eduardburlacu/IDP/README.md

# IDP

## Dimensions
- Truck Height: 95mm
- Tunnel Width: 345mm
- Tunnel Length: 510mm
-
