eduardburlacu/IDP/Non-Technical/Project Management/Introductory Presentation IDP.pptx

## Introductory Presentation

Team Name: Work In Progress

## Management Structure

Mechanical | Electrical | Software
Aadam Iftikhar | Thomas Gaertner | Daniel Rivlin
Gabriel Bednarkiewicz | Andrew Farquharson | Eduard Burlacu

*It is important to note that these are loose descriptions, with members reassigned to various roles as the project requires.

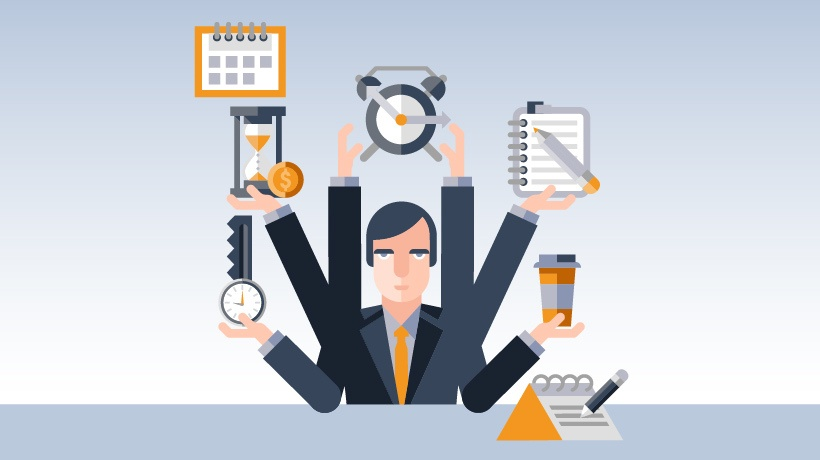
[picture p1: figure]

## Team Organisation

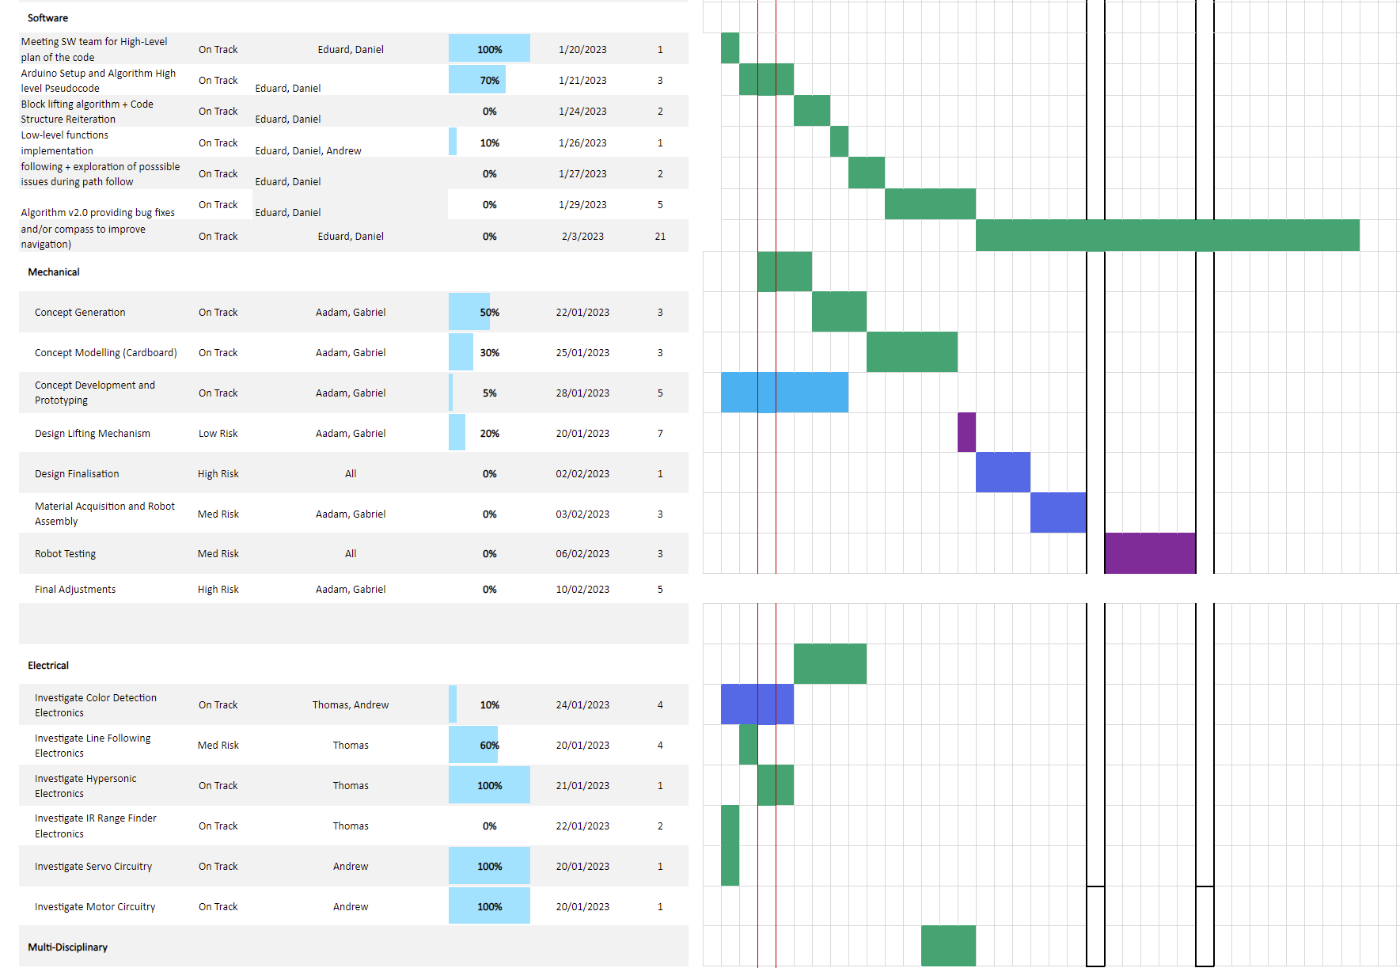
[picture p2: figure]

- Created a Gantt Chart including deadlines, work distribution, and projected timeline
- Documents and file organisation using cloud storage, version control (GitHub)
- Issues and communication addressed on a common groupchat and Issues section of repository

## THE PROBLEM

- Navigate from start point to end point and back
  - Drivetrain and navigation system required
  - Passing through tunnel and over ramp, adds additional constraints
- Collect a block from designated point
- Lift block 100mm onto truck

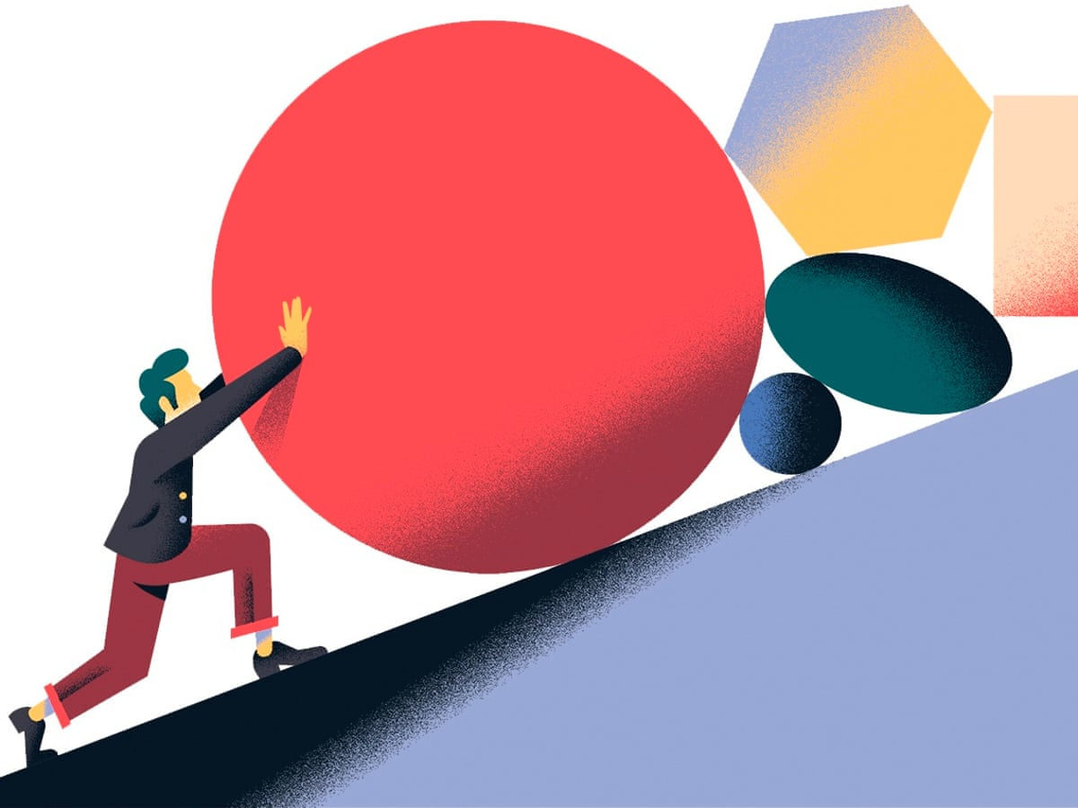
[picture p3: figure]

## SOLUTION CONCEPTS

- Navigation: Line-following (possible compass or computer vision as redundancies)
- Drivetrain: Two rear wheels, ball bearing at the front, allows for turning on the spot
- Block Collection: claw powered by servo motor
- Block Elevation: Use claw attached to lever arm mechanism

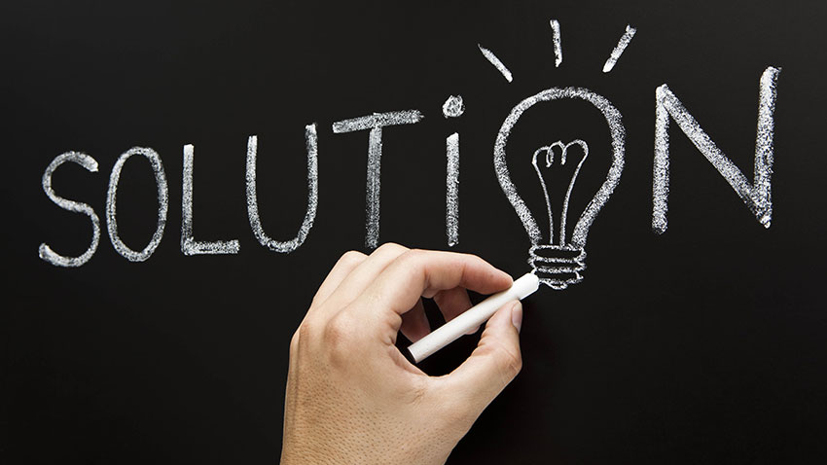
[picture p4: figure]

## Approaches

- Provided prototypes for:
  - Claw movement
  - Lift mechanism
  - Electronics and software logic

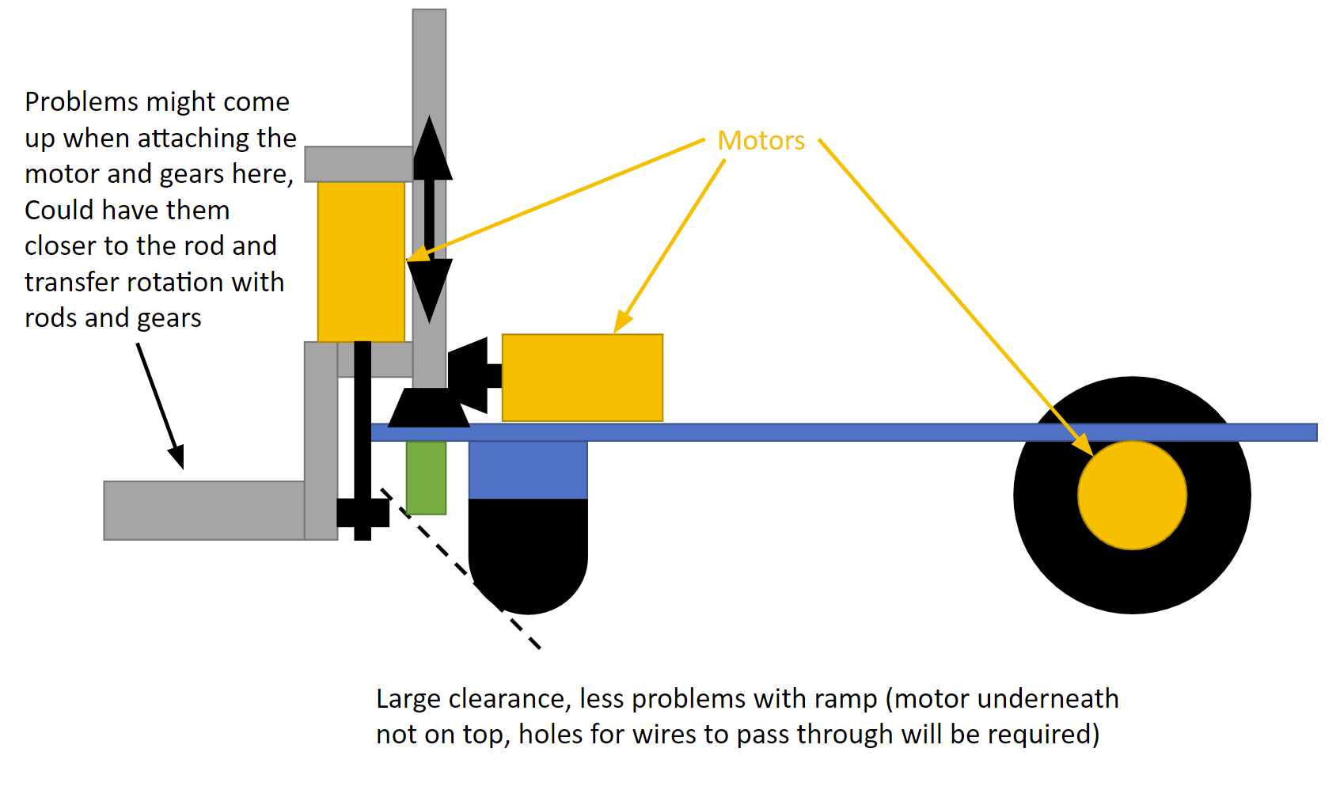
[picture p5: figure]
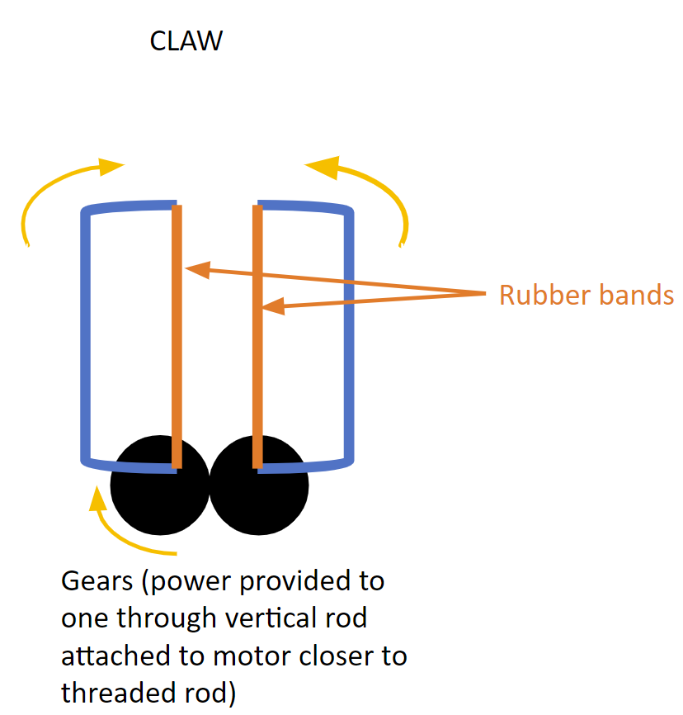
[picture p6: figure]
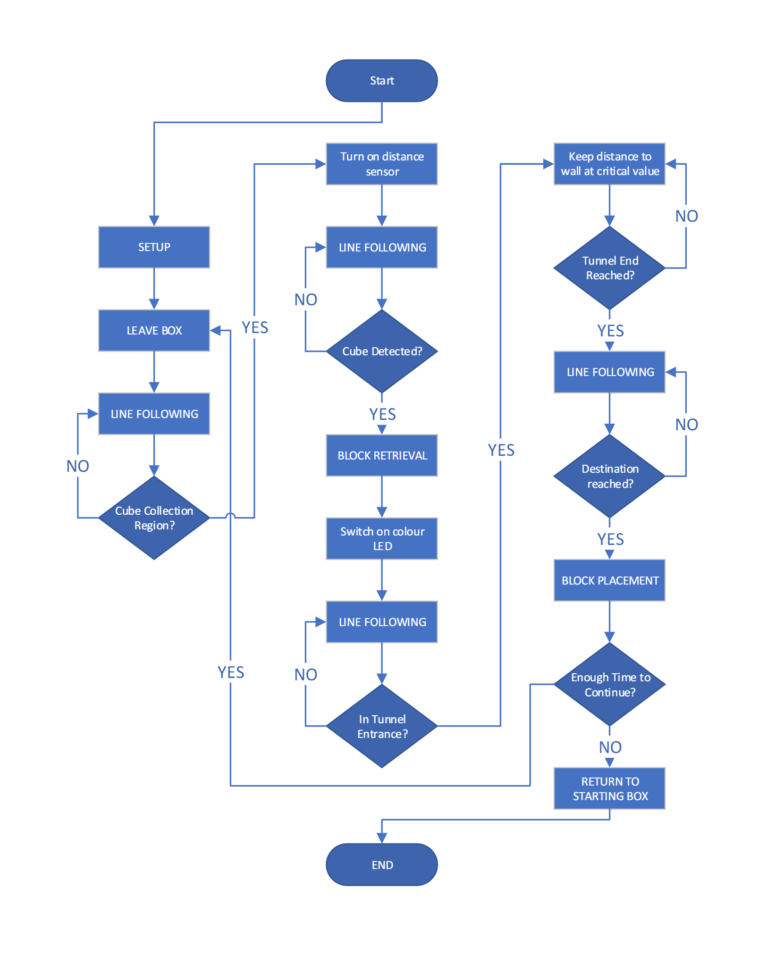
[picture p7: figure]

## Limitations

- Tunnel does not have line, accurate orientation and travel distance measurement required, limit switches as possible redundancies
- Enough torque to climb ramp is required
- Stalling servo motor is a risk, use of rubber bands to increase friction and prevent stalling
- For lifting mechanism: height of tunnel and complexity of design may increase fabrication time, claw with attached motor is heavy
- Minimum clearance to ascend ramp required
- Tunnel width limits size.

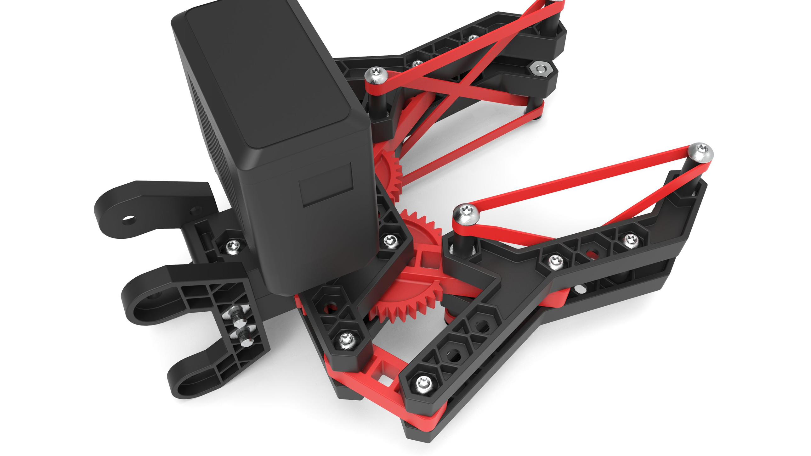
[picture p8: figure]
Robotic Claw - V5 VEX Robotics - Mecânica |Autodesk Online Gallery

## ANY QUESTIONS?

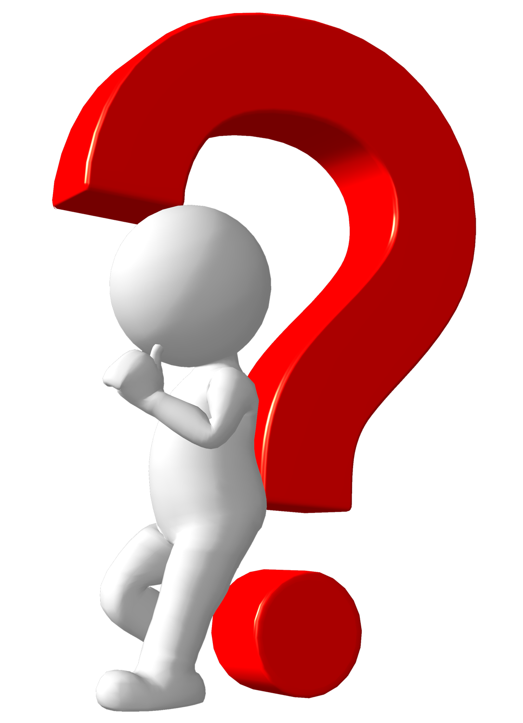
[picture p9: figure]
What is a good question? | Dragonfly Training
