eduardburlacu/IDP/Software/Charts & Diagrams/flowchart_2.pdf

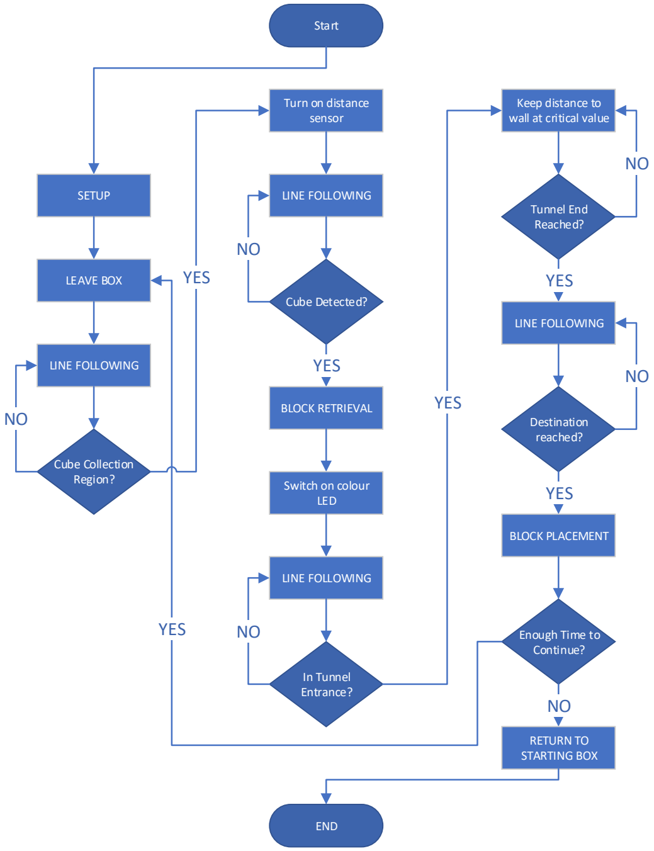
[picture p10: figure]
Start; SETUP; LEAVE BOX; LINE FOLLOWING; Cube Collection Region?; Cube Detected?; YES; BLOCK RETRIEVAL; Turn on distance sensor; Switch on colour LED; In Tunnel Entrance?; Keep distance to wall at critical value; Tunnel End Reached?; Destination reached?; BLOCK PLACEMENT; Enough Time to Continue?; RETURN TO STARTING BOX; END
