eduardburlacu/IDP/Software/Charts & Diagrams/flowchart_1.pdf

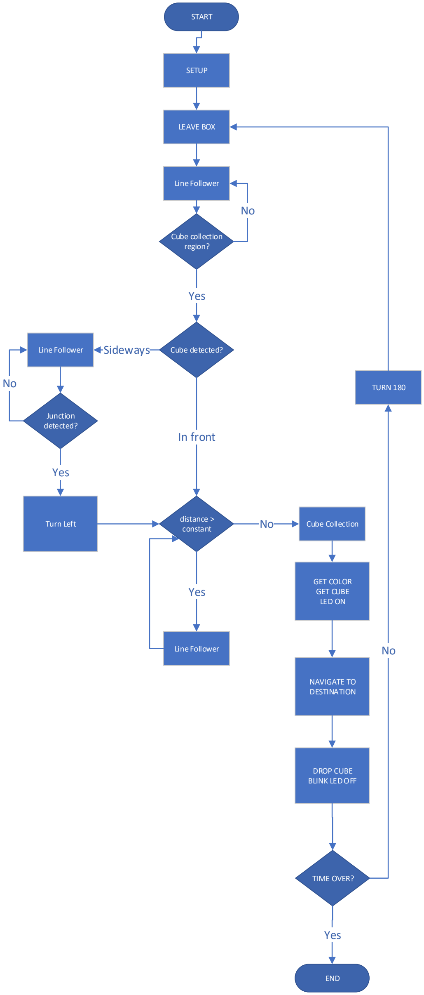
[picture p11: figure]
START; SETUP; GET COLOR GET CUBE LED ON; DROP CUBE BLINK LED OFF; TIME OVER?; END; LEAVE BOX; Line Follower; TURN 180; Cube Collection; Cube collection region?; Yes; Cube detected?; In front; distance > constant; Sideways; Junction detected?; Turn Left; NAVIGATE TO DESTINATION
