eduardburlacu/IDP/Electrical/Circuits/Line follower.png

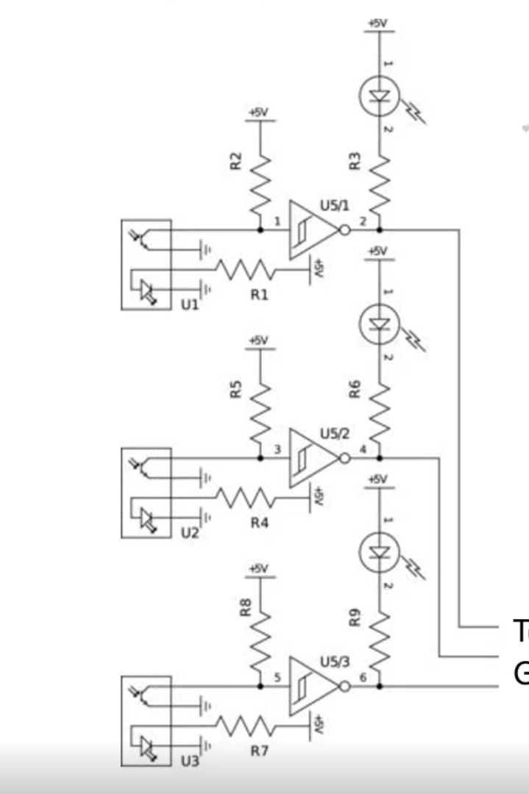
Electrical/Circuits/Line follower.png
