eduardburlacu/IDP/Mechanical/Claw/Claw.SLDASM

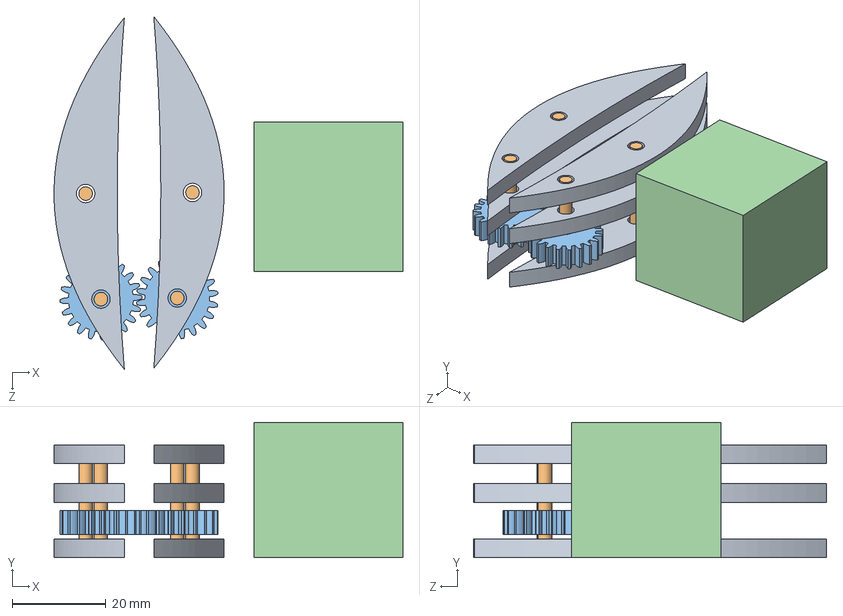
[picture p13: CAD file, 2023-01-27]
Mechanical/Claw/Claw.SLDASM
74.4 x 28.8 x 75.2 mm
Claw pincer left x 6
Rod x 4
spur gear_ai x 2
Block
