eduardburlacu/IDP/Mechanical/Claw/Block.SLDPRT

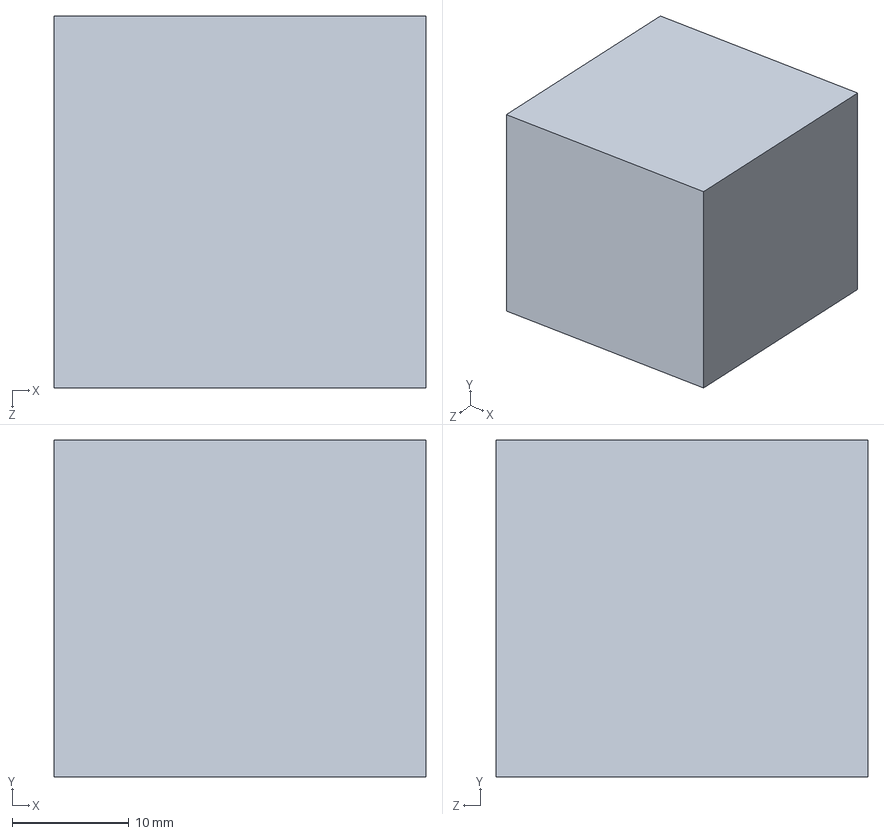
[picture p14: CAD file, 2023-01-27]
Mechanical/Claw/Block.SLDPRT
31.8 x 28.8 x 31.8 mm
