eduardburlacu/IDP/Mechanical/Claw/Rod.SLDPRT

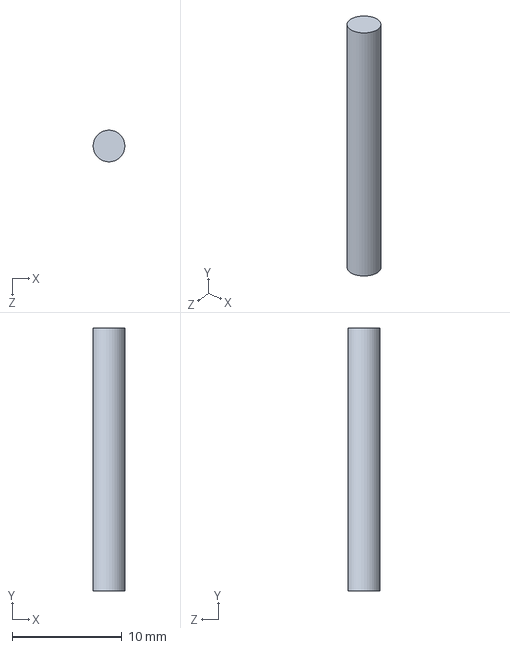
[picture p15: CAD file, 2023-01-27]
Mechanical/Claw/Rod.SLDPRT
2.90 x 24.0 x 2.90 mm
