eduardburlacu/IDP/Mechanical/Claw/Claw pincer left.SLDPRT

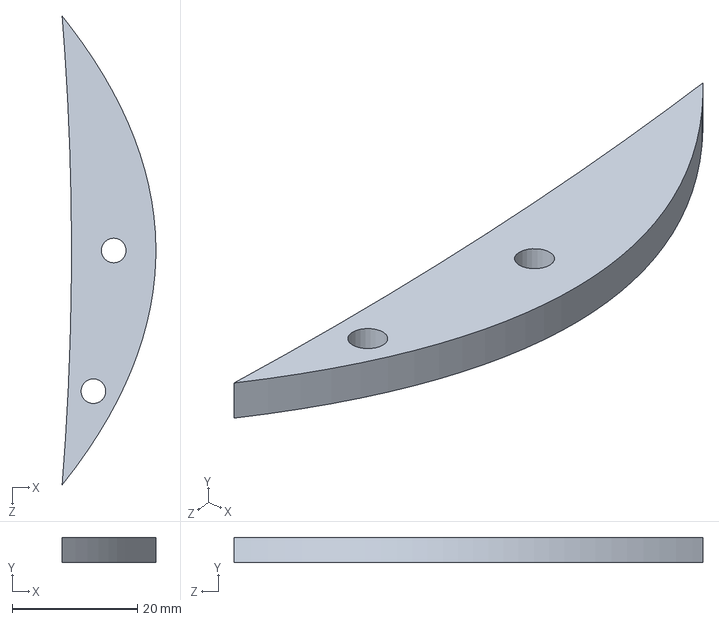
[picture p16: CAD file, 2023-01-27]
Mechanical/Claw/Claw pincer left.SLDPRT
15.0 x 4.00 x 75.0 mm
