eduardburlacu/IDP/Software/Charts & Diagrams/state_chart.pdf

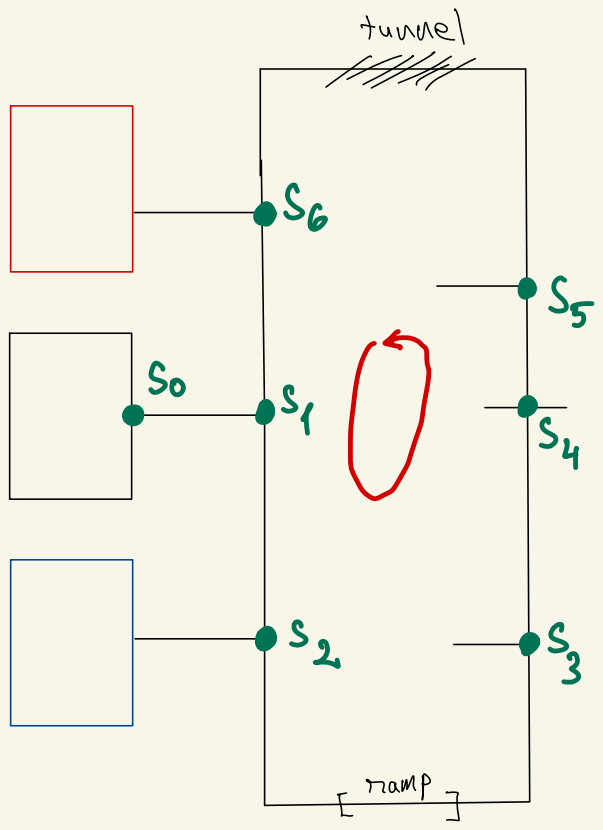
[picture p17: page 1]
namp]
