eduardburlacu/IDP/Electrical/Circuits/Timer LTSpice Schematic.asc

C1: cap; 0.01µ
C2: cap; 22µ
D1: LED; LXHL-BW02
R1: res; 20k
R2: res; 6.7k
R3: res; 100
R4: res; 1k
U1: NE555
V1: voltage; 5V
Named nets: 0, +5V, out, RST, Trig, Disch, thrs
.tran 10s
Timer can sink/source 200 mA on the output pin so no need to buffer
