eduardburlacu/IDP/Electrical/IDP/Work In Progress.brd

## EAGLE design Electrical/IDP/Work In Progress.brd (2023-01-31)

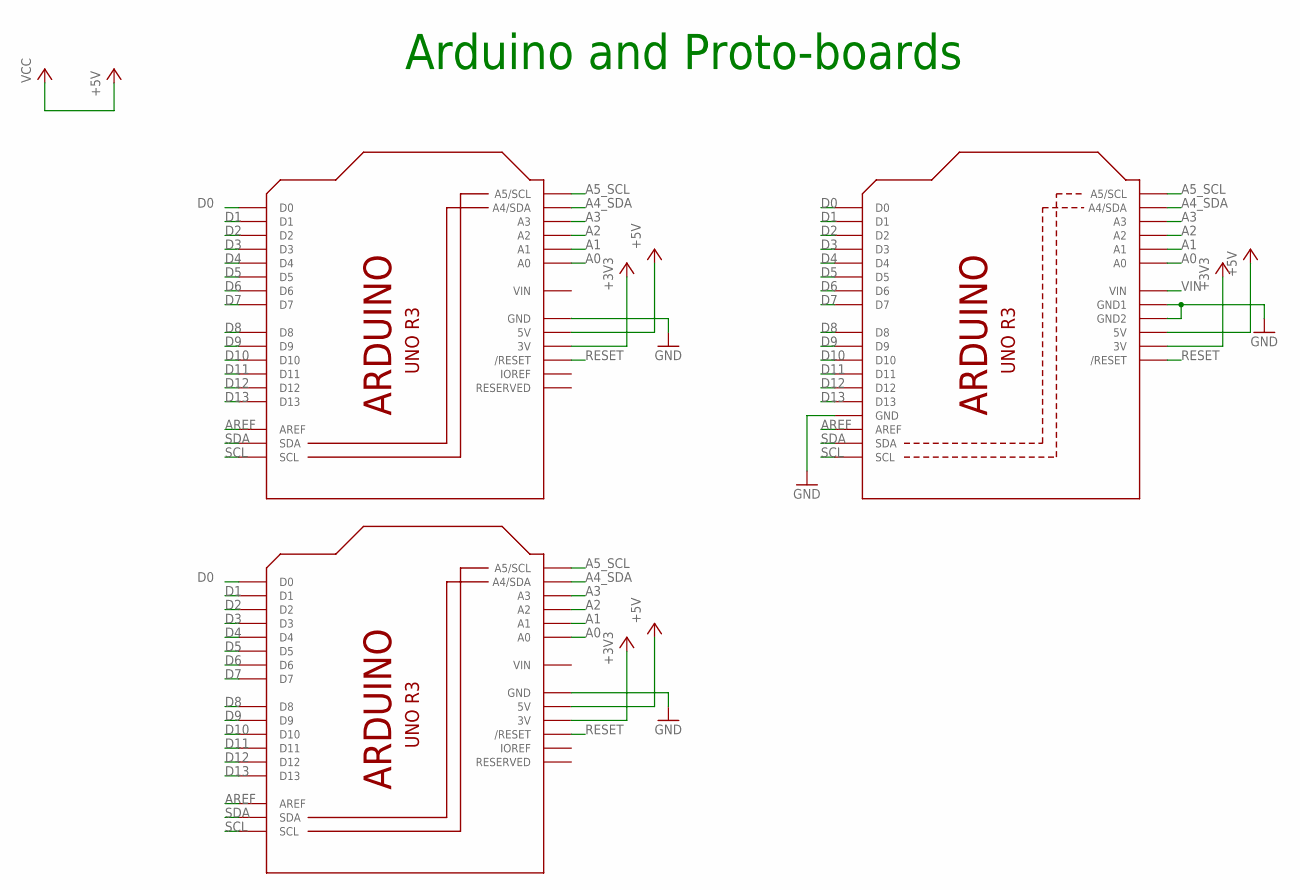
[picture p18: schematic Work In Progress.sch, sheet 1, Arduino and Proto-boards]

Parts:
M1, M2: IDP_PROTOBOARD_LARGE_LARGE; IDP_PROTO_LARGE
Q1: ARDUINOR3-NOIOREF-NOTEXT; ARDUINOR3-NOTEXT-NOIOREF

Connections:
+3V3: M1.3V, M2.3V, Q1.3V
+5V: M1.5V, M1.5V@0 (5V), M1.5V@1 (5V), M1.5V@2 (5V), M1.5V@3 (5V), M1.5V@4 (5V), M1.5V@5 (5V), M1.5V@6 (5V), M1.5V@7 (5V), M1.5V@8 (5V), M1.5V@9 (5V), M1.5V@10 (5V), M1.5V@11 (5V), M1.5V@12 (5V), M1.5V@13 (5V), M1.5V@14 (5V), M1.5V@15 (5V), M1.5V@16 (5V), M1.5V@17 (5V), M1.5V@18 (5V), M1.5V@19 (5V), M1.5V@20 (5V), M1.5V@21 (5V), M1.5V@22 (5V), M1.5V@23 (5V), M1.5V@24 (5V), M1.5V@25 (5V), M1.5V@26 (5V), M1.5V@27 (5V), M1.5V@28 (5V), M1.5V@29 (5V), M1.5V@30 (5V), M1.5V@31 (5V), M1.5V@32 (5V), M1.5V@33 (5V), M1.5V@34 (5V), M1.5V@35 (5V), M1.5V@36 (5V), M1.5V@37 (5V), M1.5V@38 (5V), M1.5V@39 (5V), M1.5V@40 (5V), M1.5V@41 (5V), M1.5V@42 (5V), M1.5V@43 (5V), M1.5V@44 (5V), M1.5V@45 (5V), M1.5V@46 (5V), M1.5V@47 (5V), M1.5V@48 (5V), M1.5V@49 (5V), M1.5V@50 (5V), M1.5V@51 (5V), M1.5V@52 (5V), M1.5V@53 (5V), M1.5V@54 (5V), M1.5V@55 (5V), M1.5V@56 (5V), M1.5V@57 (5V), M1.5V@58 (5V), M1.5V@59 (5V), M1.5V@60 (5V), M1.5V@61 (5V), M1.5V@62 (5V), M1.5V@63 (5V), M1.5V@64 (5V), M1.5V@65 (5V), M1.5V@66 (5V), M1.5V@67 (5V), M1.5V@68 (5V), M1.5V@69 (5V), M1.5V@70 (5V), M2.5V, M2.5V@0 (5V), M2.5V@1 (5V), M2.5V@2 (5V), M2.5V@3 (5V), M2.5V@4 (5V), M2.5V@5 (5V), M2.5V@6 (5V), M2.5V@7 (5V), M2.5V@8 (5V), M2.5V@9 (5V), M2.5V@10 (5V), M2.5V@11 (5V), M2.5V@12 (5V), M2.5V@13 (5V), M2.5V@14 (5V), M2.5V@15 (5V), M2.5V@16 (5V), M2.5V@17 (5V), M2.5V@18 (5V), M2.5V@19 (5V), M2.5V@20 (5V), M2.5V@21 (5V), M2.5V@22 (5V), M2.5V@23 (5V), M2.5V@24 (5V), M2.5V@25 (5V), M2.5V@26 (5V), M2.5V@27 (5V), M2.5V@28 (5V), M2.5V@29 (5V), M2.5V@30 (5V), M2.5V@31 (5V), M2.5V@32 (5V), M2.5V@33 (5V), M2.5V@34 (5V), M2.5V@35 (5V), M2.5V@36 (5V), M2.5V@37 (5V), M2.5V@38 (5V), M2.5V@39 (5V), M2.5V@40 (5V), M2.5V@41 (5V), M2.5V@42 (5V), M2.5V@43 (5V), M2.5V@44 (5V), M2.5V@45 (5V), M2.5V@46 (5V), M2.5V@47 (5V), M2.5V@48 (5V), M2.5V@49 (5V), M2.5V@50 (5V), M2.5V@51 (5V), M2.5V@52 (5V), M2.5V@53 (5V), M2.5V@54 (5V), M2.5V@55 (5V), M2.5V@56 (5V), M2.5V@57 (5V), M2.5V@58 (5V), M2.5V@59 (5V), M2.5V@60 (5V), M2.5V@61 (5V), M2.5V@62 (5V), M2.5V@63 (5V), M2.5V@64 (5V), M2.5V@65 (5V), M2.5V@66 (5V), M2.5V@67 (5V), M2.5V@68 (5V), M2.5V@69 (5V), M2.5V@70 (5V), Q1.5V; also elsewhere on the board
A0: M1.A0, M2.A0, Q1.A0
A1: M1.A1, M2.A1, Q1.A1
A2: M1.A2, M2.A2, Q1.A2
A3: M1.A3, M2.A3, Q1.A3
A4_SDA: M1.A4 (A4/SDA), M2.A4 (A4/SDA), Q1.A4 (A4/SDA)
A5_SCL: M1.A5 (A5/SCL), M2.A5 (A5/SCL), Q1.A5 (A5/SCL)
AREF: M1.AREF, M2.AREF, Q1.AREF
D0: M1.D0, M2.D0, Q1.D0
D1: M1.D1, M2.D1, Q1.D1; also elsewhere on the board
D2: M1.D2, M2.D2, Q1.D2; also elsewhere on the board
D3: M1.D3, M2.D3, Q1.D3; also elsewhere on the board
D4: M1.D4, M2.D4, Q1.D4; also elsewhere on the board
D5: M1.D5, M2.D5, Q1.D5
D6: M1.D6, M2.D6, Q1.D6
D7: M1.D7, M2.D7, Q1.D7
D8: M1.D8, M2.D8, Q1.D8; also elsewhere on the board
D9: M1.D9, M2.D9, Q1.D9; also elsewhere on the board
D10: M1.D10, M2.D10, Q1.D10; also elsewhere on the board
D11: M1.D11, M2.D11, Q1.D11; also elsewhere on the board
D12: M1.D12, M2.D12, Q1.D12
D13: M1.D13, M2.D13, Q1.D13
GND: M1.GND, M1.GND1 (GND), M1.GND2 (GND), M1.GND3 (GND), M1.GND4 (GND), M1.GND5 (GND), M1.GND6 (GND), M1.GND7 (GND), M1.GND8 (GND), M1.GND9 (GND), M1.GND10 (GND), M1.GND11 (GND), M1.GND12 (GND), M1.GND13 (GND), M1.GND14 (GND), M1.GND15 (GND), M1.GND16 (GND), M1.GND17 (GND), M1.GND18 (GND), M1.GND19 (GND), M1.GND20 (GND), M1.GND21 (GND), M1.GND22 (GND), M1.GND23 (GND), M1.GND24 (GND), M1.GND25 (GND), M1.GND26 (GND), M1.GND27 (GND), M1.GND28 (GND), M1.GND29 (GND), M1.GND30 (GND), M1.GND31 (GND), M1.GND32 (GND), M1.GND33 (GND), M1.GND@1 (GND), M1.GND@2 (GND), M1.GND@3 (GND), M1.GND@4 (GND), M1.GND@5 (GND), M1.GND@6 (GND), M1.GND@7 (GND), M1.GND@8 (GND), M1.GND@9 (GND), M1.GND@10 (GND), M1.GND@11 (GND), M1.GND@12 (GND), M1.GND@13 (GND), M1.GND@14 (GND), M1.GND@15 (GND), M1.GND@16 (GND), M1.GND@17 (GND), M1.GND@26 (GND), M1.GND@27 (GND), M1.GND@28 (GND), M1.GND@29 (GND), M1.GND@30 (GND), M1.GND@31 (GND), M1.GND@32 (GND), M1.GND@33 (GND), M1.GND@34 (GND), M1.GND@35 (GND), M1.GND@36 (GND), M1.GND@37 (GND), M1.GND@38 (GND), M1.GND@39 (GND), M1.GND@40 (GND), M1.GND@41 (GND), M1.GND@42 (GND), M1.GND@43 (GND), M1.GND@44 (GND), M1.GND@45 (GND), M1.GND@46 (GND), M1.GND@47 (GND), M1.GND@48 (GND), M2.GND, M2.GND1 (GND), M2.GND2 (GND), M2.GND3 (GND), M2.GND4 (GND), M2.GND5 (GND), M2.GND6 (GND), M2.GND7 (GND), M2.GND8 (GND), M2.GND9 (GND), M2.GND10 (GND), M2.GND11 (GND), M2.GND12 (GND), M2.GND13 (GND), M2.GND14 (GND), M2.GND15 (GND), M2.GND16 (GND), M2.GND17 (GND), M2.GND18 (GND), M2.GND19 (GND), M2.GND20 (GND), M2.GND21 (GND), M2.GND22 (GND), M2.GND23 (GND), M2.GND24 (GND), M2.GND25 (GND), M2.GND26 (GND), M2.GND27 (GND), M2.GND28 (GND), M2.GND29 (GND), M2.GND30 (GND), M2.GND31 (GND), M2.GND32 (GND), M2.GND33 (GND), M2.GND@1 (GND), M2.GND@2 (GND), M2.GND@3 (GND), M2.GND@4 (GND), M2.GND@5 (GND), M2.GND@6 (GND), M2.GND@7 (GND), M2.GND@8 (GND), M2.GND@9 (GND), M2.GND@10 (GND), M2.GND@11 (GND), M2.GND@12 (GND), M2.GND@13 (GND), M2.GND@14 (GND), M2.GND@15 (GND), M2.GND@16 (GND), M2.GND@17 (GND), M2.GND@26 (GND), M2.GND@27 (GND), M2.GND@28 (GND), M2.GND@29 (GND), M2.GND@30 (GND), M2.GND@31 (GND), M2.GND@32 (GND), M2.GND@33 (GND), M2.GND@34 (GND), M2.GND@35 (GND), M2.GND@36 (GND), M2.GND@37 (GND), M2.GND@38 (GND), M2.GND@39 (GND), M2.GND@40 (GND), M2.GND@41 (GND), M2.GND@42 (GND), M2.GND@43 (GND), M2.GND@44 (GND), M2.GND@45 (GND), M2.GND@46 (GND), M2.GND@47 (GND), M2.GND@48 (GND), Q1.GND, Q1.GND1, Q1.GND2; also elsewhere on the board
RESET: M1.RESET (/RESET), M2.RESET (/RESET), Q1.RESET (/RESET)
SCL: M1.SCL, M2.SCL, Q1.SCL
SDA: M1.SDA, M2.SDA, Q1.SDA
VIN: Q1.VIN

Notes on the sheet:
Arduino and Proto-boards

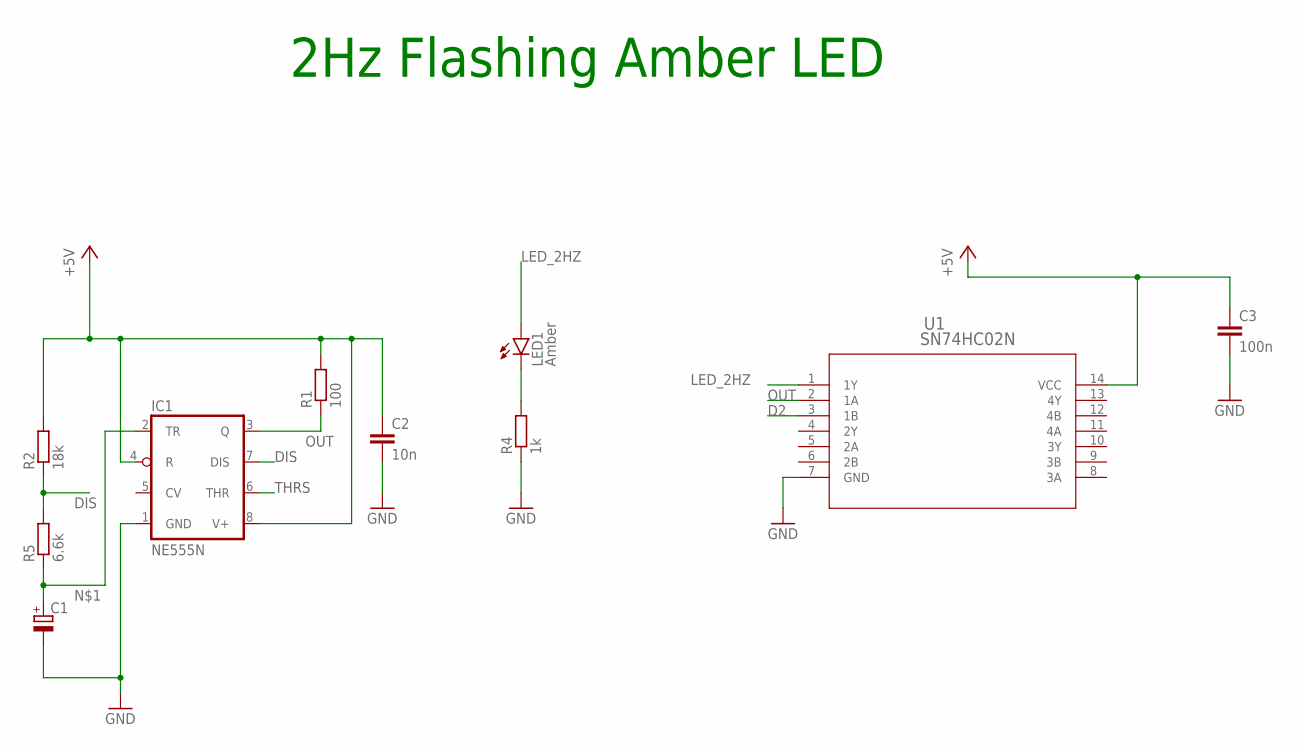
[picture p19: schematic Work In Progress.sch, sheet 2, 2Hz Amber LED Blinking Circuit]

Parts:
C1: CPOL-EUTT2D4; TT2D4
C2: 10n; C025-024X044
C3: 100n; C025-024X044
IC1: NE555N; DIL08-ROUND
LED1: Amber; LED3MM
R1: 100; 0204V
R2: 18k; 0204V
R4: 1k; 0204V
R5: 6.6k; 0204V
U1: SN74HC02N; N14

Connections:
+5V: C2.1, C3.1, IC1.4 (R), IC1.8 (V+), R1.2, R2.2, U1.14 (VCC); also elsewhere on the board
D2: U1.3 (1B); also elsewhere on the board
DIS: IC1.7 (DIS), R2.1, R5.2
GND: C1.-, C2.2, C3.2, IC1.1 (GND), R4.1, U1.7 (GND); also elsewhere on the board
LED_2HZ: LED1.A, U1.1 (1Y)
unnamed: C1.+, IC1.2 (TR), R5.1
unnamed: LED1.K (C), R4.2
OUT: IC1.3 (Q), R1.1, U1.2 (1A)
THRS: IC1.6 (THR)

Notes on the sheet:
2Hz Flashing Amber LED

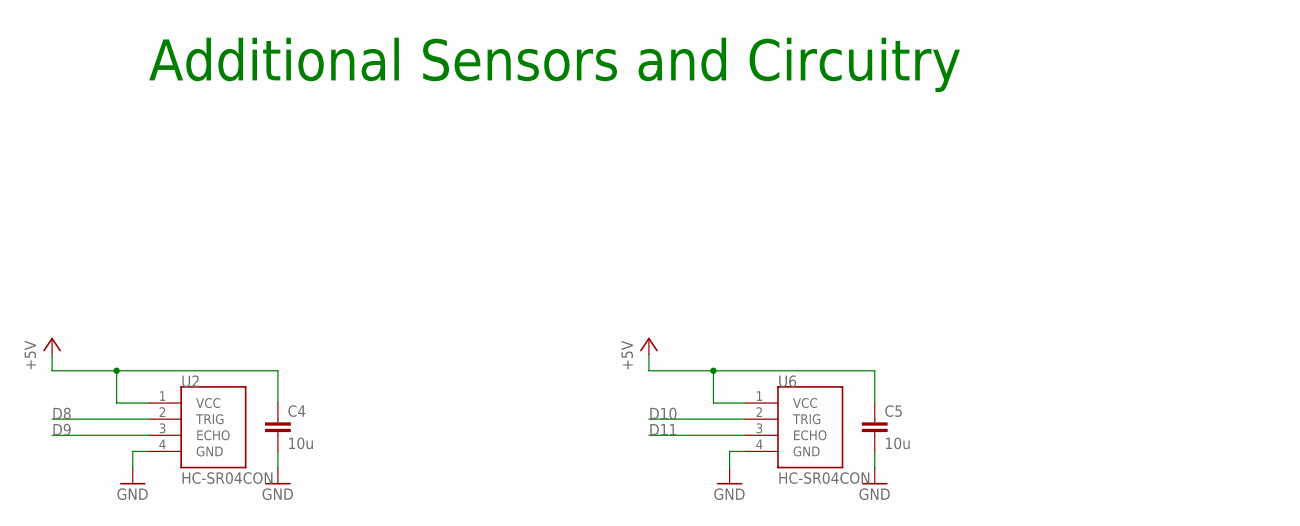
[picture p20: schematic Work In Progress.sch, sheet 3, Additional Sensors and Circuitry]

Parts:
C4, C5: 10u; C025-024X044
U2, U6: HC-SR04CON; 22-23-2041

Connections:
+5V: C4.1, C5.1, U2.1 (VCC), U6.1 (VCC); also elsewhere on the board
D8: U2.2 (TRIG); also elsewhere on the board
D9: U2.3 (ECHO); also elsewhere on the board
D10: U6.2 (TRIG); also elsewhere on the board
D11: U6.3 (ECHO); also elsewhere on the board
GND: C4.2, C5.2, U2.4 (GND), U6.4 (GND); also elsewhere on the board

Notes on the sheet:
Additional Sensors and Circuitry

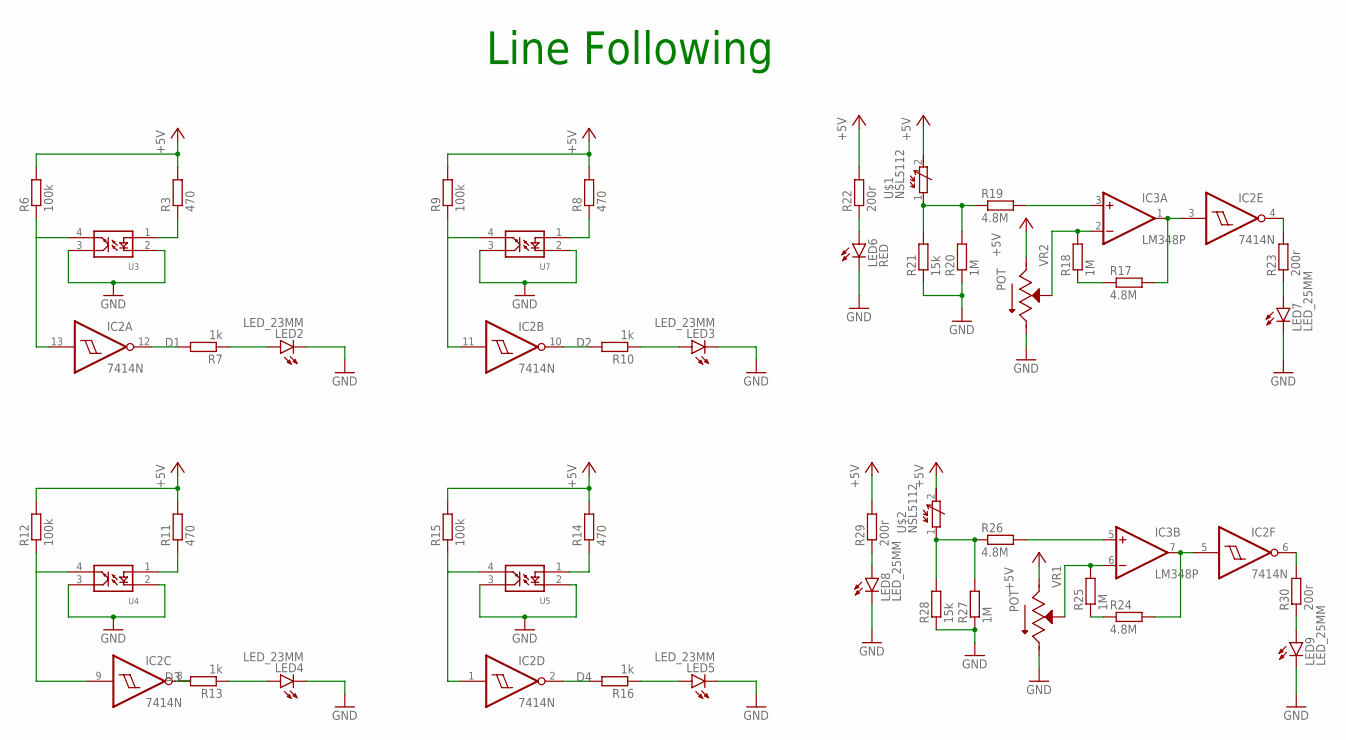
[picture p21: schematic Work In Progress.sch, sheet 4, Line Following]

Parts:
IC2: 7414N; DIL14
IC3: LM348P; DIL14
LED2, LED3, LED4, LED5: LED_23MM; LED3MM
LED6: RED; LED5MM
LED7, LED8, LED9: LED_25MM; LED5MM
R3, R8, R11, R14: 470; 0204V
R6, R9, R12, R15: 100k; 0204V
R7, R10, R13, R16: 1k; 0204V
R17, R19, R24, R26: 4.8M; 0204V
R18, R20, R25, R27: 1M; 0204V
R21, R28: 15k; 0204V
R22, R23, R29, R30: 200r; 0204V
U3, U4, U5, U7: OPB704; 22-23-2041
U$1, U$2: NSL5112; KK-156-2
VR1, VR2: POT; TRIM_3296W-1-250

Connections:
+5V: R3.2, R6.2, R8.2, R9.2, R11.2, R12.2, R14.2, R15.2, R22.2, R29.2, U$1.2 (E), U$2.2 (E), VR1.1 (CCW), VR2.1 (CCW); also elsewhere on the board
D1: IC2.12 (O), R7.2; also elsewhere on the board
D2: IC2.10 (O), R10.2; also elsewhere on the board
D3: IC2.8 (O), R13.2; also elsewhere on the board
D4: IC2.2 (O), R16.2; also elsewhere on the board
GND: IC2.7 (GND), LED2.K (C), LED3.K (C), LED4.K (C), LED5.K (C), LED6.K (C), LED7.K (C), LED8.K (C), LED9.K (C), R20.1, R21.1, R27.1, R28.1, U3.2 (1), U3.3, U4.2 (1), U4.3, U5.2 (1), U5.3, U7.2 (1), U7.3, VR1.3 (CW), VR2.3 (CW); also elsewhere on the board
unnamed: R3.1, U3.1 (2)
unnamed: LED2.A, R7.1
unnamed: IC2.13 (I), R6.1, U3.4
unnamed: R8.1, U7.1 (2)
unnamed: IC2.11 (I), R9.1, U7.4
unnamed: LED3.A, R10.1
unnamed: R11.1, U4.1 (2)
unnamed: IC2.9 (I), R12.1, U4.4
unnamed: LED4.A, R13.1
unnamed: R14.1, U5.1 (2)
unnamed: IC2.1 (I), R15.1, U5.4
unnamed: LED5.A, R16.1
unnamed: R17.1, R18.1
unnamed: IC2.3 (I), IC3.1 (OUT), R17.2
unnamed: IC3.2 (-IN), R18.2, VR2.2 (WIPER)
unnamed: IC3.3 (+IN), R19.2
unnamed: R19.1, R20.2, R21.2, U$1.1 (A)
unnamed: LED6.A, R22.1
unnamed: LED7.A, R23.1
unnamed: IC2.4 (O), R23.2
unnamed: R24.1, R25.1
unnamed: IC2.5 (I), IC3.7 (OUT), R24.2
unnamed: IC3.6 (-IN), R25.2, VR1.2 (WIPER)
unnamed: IC3.5 (+IN), R26.2
unnamed: R26.1, R27.2, R28.2, U$2.1 (A)
unnamed: LED8.A, R29.1
unnamed: LED9.A, R30.1
unnamed: IC2.6 (O), R30.2
V+: IC3.4 (V+)
V-: IC3.11 (V-)
VCC: IC2.14 (VCC)

Notes on the sheet:
Line Following

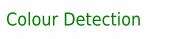
[picture p22: schematic Work In Progress.sch, sheet 5, Colour Detection]

Notes on the sheet:
Colour Detection

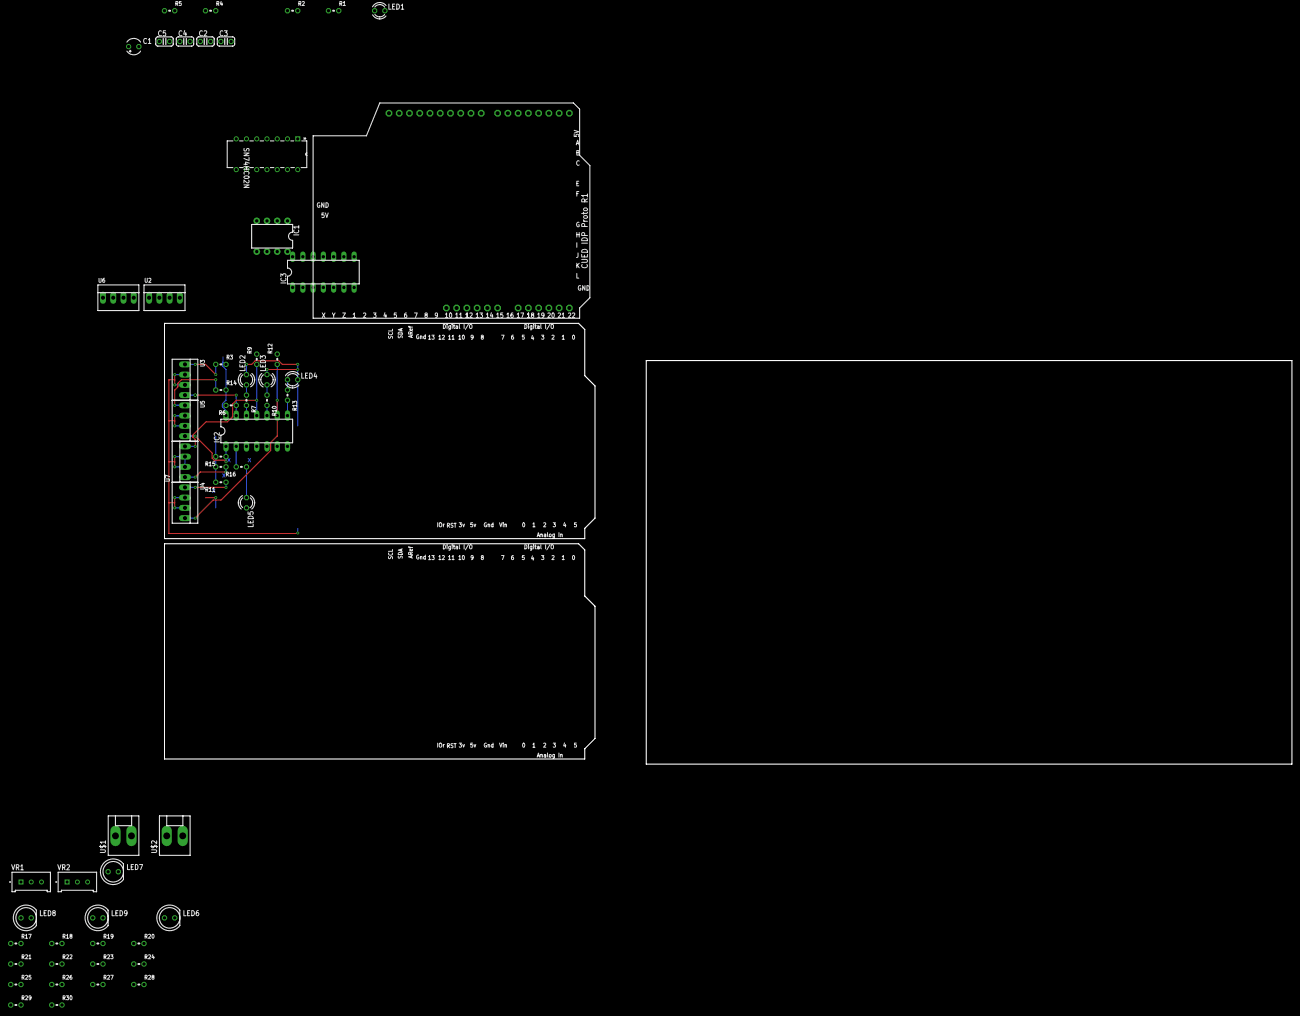
[picture p23: board Work In Progress.brd from above]

Board: 2 copper layers, 279.4 x 109.2 mm, 61 parts (0 on the bottom side), 60 nets.
