eduardburlacu/IDP/Electrical/Circuits/2hz timer/2hz timer.sch

## EAGLE design Electrical/Circuits/2hz timer/2hz timer.sch (2023-01-26)

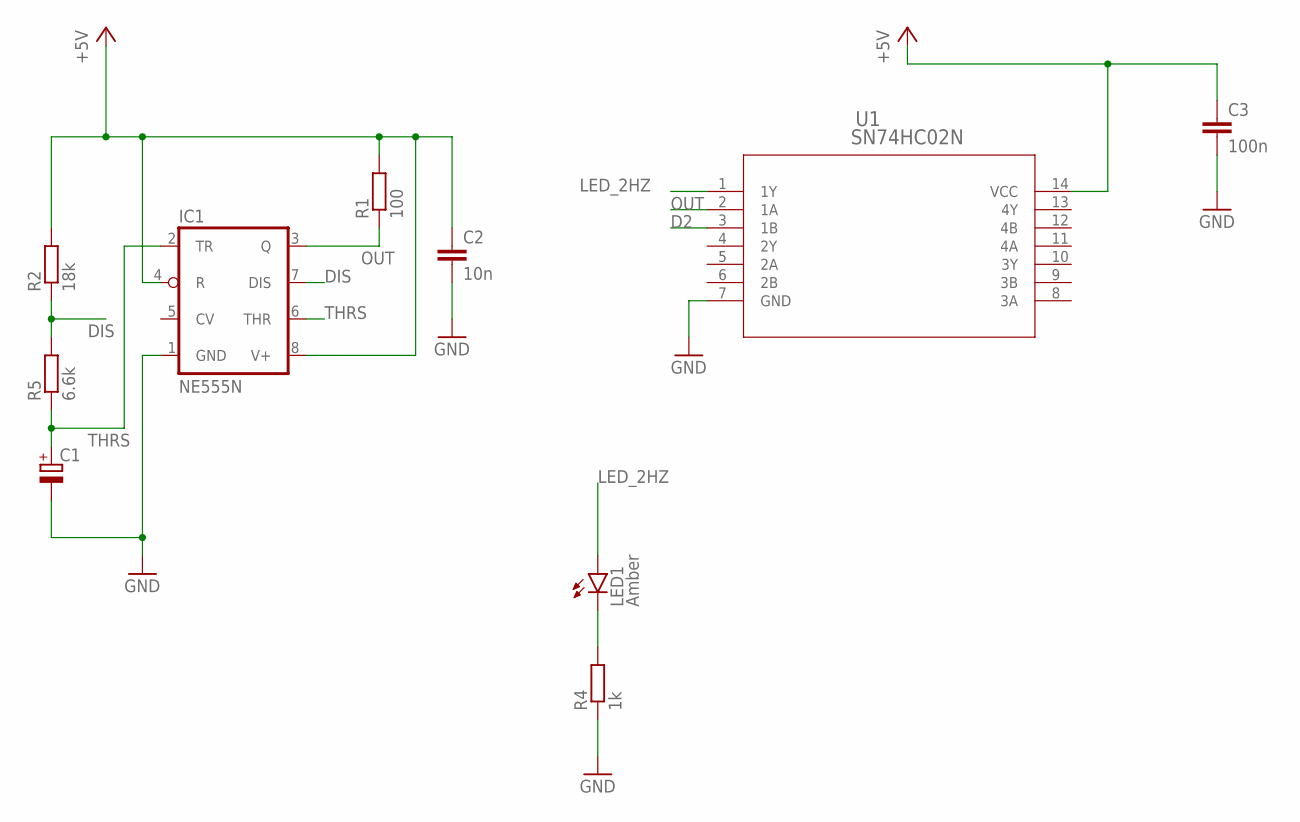
[picture p24: schematic 2hz timer.sch]

Parts:
C1: CPOL-EUTT2D4; TT2D4
C2: 10n; C025-024X044
C3: 100n; C025-024X044
IC1: NE555N; DIL08-ROUND
LED1: Amber; LED3MM
R1: 100; 0204/7
R2: 18k; 0204/7
R4: 1k; 0204/7
R5: 6.6k; 0204/7
U1: SN74HC02N; N14

Connections:
+5V: C2.1, C3.1, IC1.4 (R), IC1.8 (V+), R1.2, R2.2, U1.14 (VCC)
D2: U1.3 (1B)
DIS: IC1.7 (DIS), R2.1, R5.2
GND: C1.-, C2.2, C3.2, IC1.1 (GND), R4.1, U1.7 (GND)
LED_2HZ: LED1.A, U1.1 (1Y)
unnamed: LED1.K (C), R4.2
OUT: IC1.3 (Q), R1.1, U1.2 (1A)
THRS: C1.+, IC1.2 (TR), IC1.6 (THR), R5.1
