eduardburlacu/IDP/Electrical/Circuits/Colour Detector/Colour Detector.sch

## EAGLE design Electrical/Circuits/Colour Detector/Colour Detector.sch (2023-01-26)

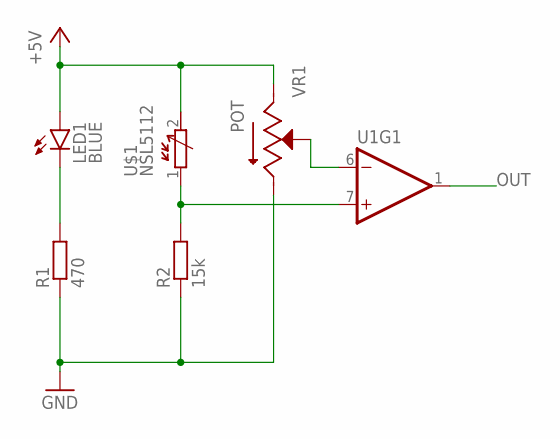
[picture p25: schematic Colour Detector.sch]

Parts:
LED1: BLUE; LED3MM
R1: 470; 0204/7
R2: 15k; 0204/7
U1: LM339DIP; DIL14
U$1: NSL5112; KK-156-2
VR1: POT; TRIM_3296W-1-250

Connections:
+5V: LED1.A, U$1.2 (E), VR1.1 (CCW)
GND: R1.1, R2.1, VR1.3 (CW)
unnamed: LED1.K (C), R1.2
unnamed: R2.2, U1.7 (+IN), U$1.1 (A)
unnamed: U1.6 (-IN), VR1.2 (WIPER)
OUT: U1.1 (OUT)
