eduardburlacu/IDP/Electrical/Circuits/Line Following/Line Follower.sch

## EAGLE design Electrical/Circuits/Line Following/Line Follower.sch (2023-01-20)

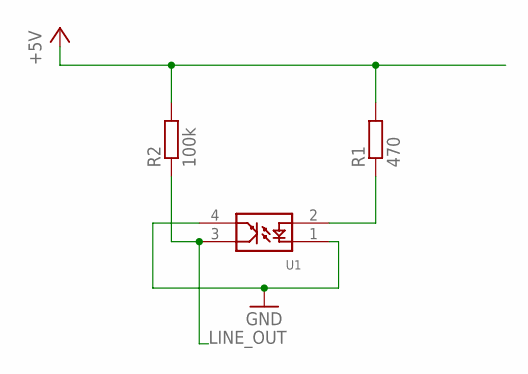
[picture p26: schematic Line Follower.sch]

Parts:
R1: 470; 0204/7
R2: 100k; 0204/7
U1: OPB704; 22-23-2041

Connections:
+5V: R1.2, R2.2
GND: U1.1, U1.4
LINE_OUT: R2.1, U1.3
unnamed: R1.1, U1.2
