eduardburlacu/IDP/Electrical/Circuits/SHARP 2Y0A02 IR Range Finder/Sharp IR Distance 2YA02.sch

## EAGLE design Electrical/Circuits/SHARP 2Y0A02 IR Range Finder/Sharp IR Distance 2YA02.sch (2023-01-26)

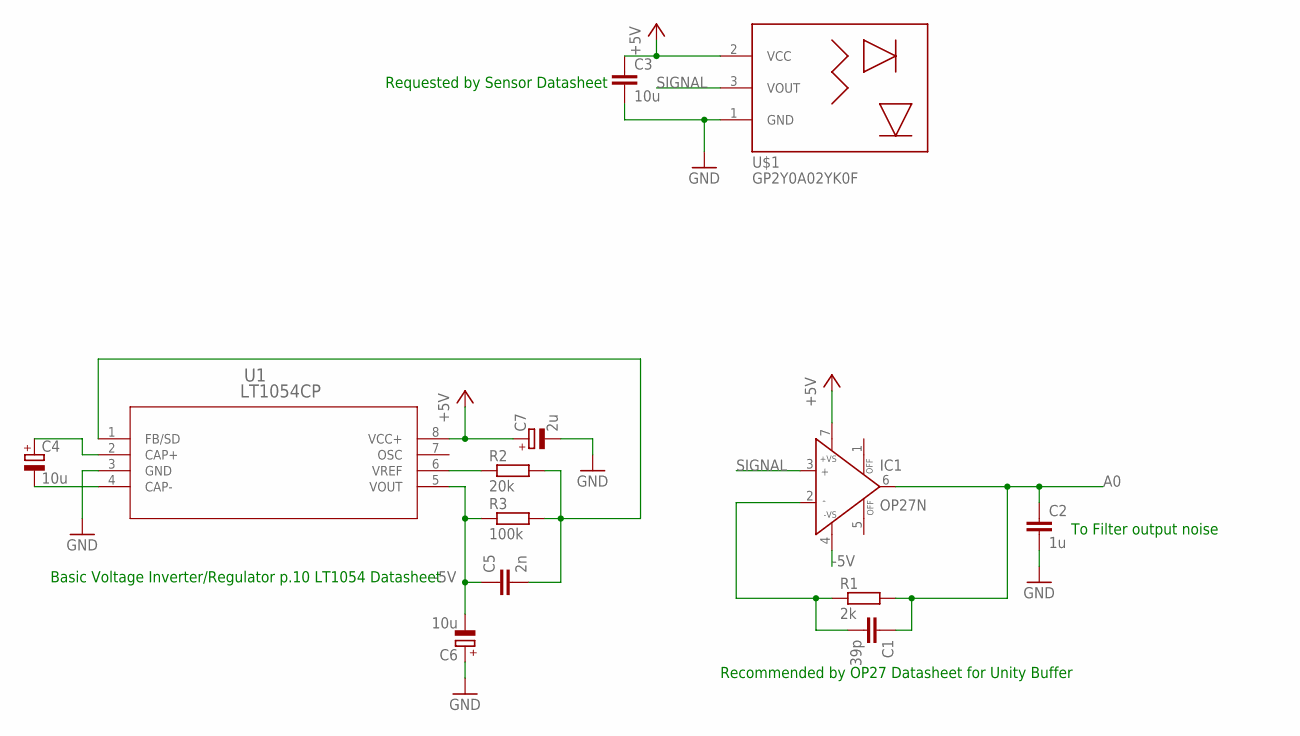
[picture p27: schematic Sharp IR Distance 2YA02.sch]

Parts:
C1: 39p; C025-024X044
C2: 1u; C025-024X044
C3: 10u; C025-024X044
C4, C6: 10u; TT2D5
C5: 2n; C025-024X044
C7: 2u; TT2D5
IC1: OP27N; DIL08
R1: 2k; 0204/7
R2: 20k; 0204/7
R3: 100k; 0204/7
U1: LT1054CP; P8
U$1: GP2Y0A02YK0F; 22-23-2031

Connections:
+5V: C3.1, C7.+, IC1.7 (+VS), U1.8 (VCC+), U$1.2 (VCC)
-5V: C5.1, C6.-, IC1.4 (-VS), R3.1, U1.5 (VOUT)
A0: C1.1, C2.1, IC1.6 (OUT), R1.2
GND: C2.2, C3.2, C6.+, C7.-, U1.3 (GND), U$1.1 (GND)
unnamed: C4.+, U1.2 (CAP+)
unnamed: C1.2, IC1.2 (IN-), R1.1
unnamed: C4.-, U1.4 (CAP-)
unnamed: R2.1, U1.6 (VREF)
unnamed: C5.2, R2.2, R3.2, U1.1 (FB/SD)
SIGNAL: IC1.3 (IN+), U$1.3 (VOUT)

Notes on the sheet:
To Filter output noise
Recommended by OP27 Datasheet for Unity Buffer
Requested by Sensor Datasheet
Basic Voltage Inverter/Regulator p.10 LT1054 Datasheet
