eduardburlacu/IDP/Electrical/Circuits/Ultrasonic/ultrasonic.sch

## EAGLE design Electrical/Circuits/Ultrasonic/ultrasonic.sch (2023-01-23)

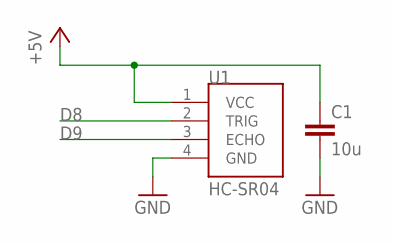
[picture p28: schematic ultrasonic.sch]

Parts:
C1: 10u; C075-032X103
U1: HC-SR04; XCVR_HC-SR04

Connections:
+5V: C1.1, U1.1 (VCC)
D8: U1.2 (TRIG)
D9: U1.3 (ECHO)
GND: C1.2, U1.4 (GND)
