eduardburlacu/IDP/(commit log)

2023-01-19 Added Project Documents
    [Project Timeline.xlsx]
2023-01-19 Added Moodle Resources
    [623-flanged.SLDASM, 624-flanged.SLDASM, 625-flanged.SLDASM, Battery_box_RL6165-F.stp, Mclennan 1271-2stage.stp, Mclennan_1308-3stage.stp, OLD .SLDPRT, OLD 100mm_wheel.SLDASM]
2023-01-20 Added Gantt Chart
    [Gantt Chart.xlsx]
2023-01-20 Added Line Follower circuitry and schematic.
    [Line Follower.sch]
2023-01-21 Added Ultrasonic Sensor code and schematic
    [ultrasonic.sch]
2023-01-22 Added Circuits for Sharp 2Y0A02 IR Range Finder
    [Sharp IR Distance 2YA02.sch]
2023-01-23 ADDED FLOWCHART
2023-01-23 Updated Ultrasonic Schematic capacitance
    [ultrasonic.sch]
2023-01-23 Add files via upload
    Updated Flowchart
2023-01-24 Added Schematic for NE555p timer circut for 2Hz operation
2023-01-26 Updated IR Range Finder schematic
    [Sharp IR Distance 2YA02.sch]
2023-01-26 Added colour detector schematic
    [Colour Detector.sch]
2023-01-26 Added timer schematic and updated eagle library
    [2hz timer.sch]
2023-01-26 Add files via upload
    This is the claw file. It is not fully finished as everything has not been fully mated but everything is in the right place.
    [Claw.SLDASM]
2023-01-27 Claw pieces
    [Claw pincer left.SLDPRT, Rod.SLDPRT]
2023-01-27 Mated Claw assembly and added block model
    [Claw pincer left.SLDPRT, Claw.SLDASM, Rod.SLDPRT]
2023-01-27 Added solidworks models for claw
    [Block.SLDPRT, Claw pincer left.SLDPRT, Claw.SLDASM, Rod.SLDPRT]
2023-01-27 Added circuit schematics
    [Colour Dectector.sch, Line Detector.sch]
2023-01-29 Tunnel detector by side sonar done
2023-01-30 Added IDP Eagle Project Folder
    [Work In Progress.brd, Work In Progress.sch]
2023-01-31 Completed Line Follower routing
    [Work In Progress.brd, Work In Progress.sch]
2023-01-31 new line follower
    implemented like Davit's one in case the debugging for the pid is still not good
2023-02-08 Moved pinMoving high signal to be when motors start
2023-02-08 Stopped loop failing after first call
    [COMPETITION1.ino]
2023-02-08 Altered logic in state 1 switch case
2023-02-08 Fixed logic in state 0 to prevent parking issues
    [COMPETITION1.ino]
2023-02-09 Competition code bug fixes
    [COMPETITION1.ino]
2023-02-13 Added Servo Testing Code
2023-02-19 Rename Servo Testing.ino to test_servos
2023-02-19 Rename Software/Servo Testing/test_servos to Software/test_servos
2023-02-19 Rename Software/UnitTests/Motor Test/Motor Test.ino to Software/test_motors
