eduardburlacu/IDP/(notices)

Notices in the files:
parts and their libraries:
IDP_library: COPYRIGHT: Copyright (C) 2023 Ultra Librarian. All rights reserved.
